jlassahn/gamesquirrel/docs/game_programmer_guide.adoc

= GameSquirrel Game Programmer's Guide
Jeff Lassahn
0.1.0, February 23,2025
:copyright: 2025 Jeff Lassahn
:doctype: book
:toc: left
:toc-title: Table of Contents
:title-page:

[preface]
== Preface

TODO This is a book for programmers who want to write games for the GameSquirrel.

== A Chapter

TODO Chapter 1
