jlassahn/gamesquirrel/(threads)

Thread 3 (2025-05-10):

Joystick pads are the wrong size

jlassahn, 2025-05-10:
The four case mounting through hole pads for the joystick are too small.

Thread 4 (2025-05-10):

USB slot is misaligned

jlassahn, 2025-05-10:
USB connector position was moved to keep the PCB pads clear of one of the display supports.  The slot in the case must be moved to match.

Thread 5 (2025-05-10):

Switch position doesn't match slot.

jlassahn, 2025-05-10:
The power switch location on the PCB isn't aligned with the slot in the case.  Probably an error during PCB layout.
Will fix by adjusting the case design.

Thread 8 (2025-05-10):

Case PCB supports interfere with through-hole components.

jlassahn, 2025-05-10:
The joystick and indicator LEDs both have through-hole pins that make contact with the case PCB support grid.  Add cutouts as needed to make everything fit.

Thread 9 (2025-05-10):

Case top is too flexible

jlassahn, 2025-05-10:
When held with the single mounting screw, the case top is flexible enough to allow the corners near the display to bend noticeably.

Thread 10 (2025-05-11):

Oscillator chip is hard to hand solder

jlassahn, 2025-05-11:
The 16MHz Oscillator chip has pads that aren't easily reachable by a soldering iron, so it's hard to solder.  Consider choosing a different part, or making the pads bigger on the PCB.

Thread 11 (2025-05-11):

Buttons are in the wrong order

jlassahn, 2025-05-11:
The four buttons are laid out on the PCB in a weird order.

The current positions are
```
SW1  SW4
SW3  SW2
```

It was supposed to be
```
SW1  SW2
SW3  SW4
```

If fixing this on the PCB, **Make sure to not break compatibility with existing firmware**, probably the best strategy is to change the reference designators so the PCB looks right but leave the mapping between microcontroller pins and button physical positions the same.

Thread 12 (2025-05-11):

Add power On/Off labels to PCB silkscreen

jlassahn, 2025-05-11:
It would be helpful if there was a label next to SW5 that says which switch position is ON.

Thread 14 (2025-05-14):

Debug connectors interfere with display ribbon cable

jlassahn, 2025-05-14:
If the debug and boot headers are populated, the display can't lay normally above the PCB.

Thread 15 (2025-05-18):

D1 LED pins are reversed

jlassahn, 2025-05-18:
On the PCB, negative is marked as pin 1.

Thread 16 (2025-05-18):

Vbat diode dop is too small

jlassahn, 2025-05-18:
The diode added to keep Vbat going into the microcontroller, from exceeding maximum rated voltage doesn't appear to be doing that.

The current drawn by the micro on Vbat is so small that the voltage drop is much lower than 0.6V, hard to measure exactly because my multimeter is drawing enough current to skew the voltage measurement, but probably we're getting less than 0.2V.

The requirement for the micro is 4.0V absolute max, 3.6V recommended operating max.  The datasheet typical value for the diode drop is 0.6V at about 0.15mA, slope of about 0.2V per 10x current change.

Consider adding a bleed resistor to keep the diode in forward conduction. 100K would draw about 40uA, which would give voltage drop of just under 0.5V.  At maximum battery voltage of 4.2V this gives a Vbat around 3.7-3.8V, which is probably OK.  The battery drain from 40uA is 400mAH in 10,000 hours, which is more than a year.  So the extra power down current use should be fine.
