jlassahn/gamesquirrel/hardware/main_pcb/main_pcb.kicad_pcb

## KiCad design hardware/main_pcb/main_pcb.kicad_pcb (2025-04-23)

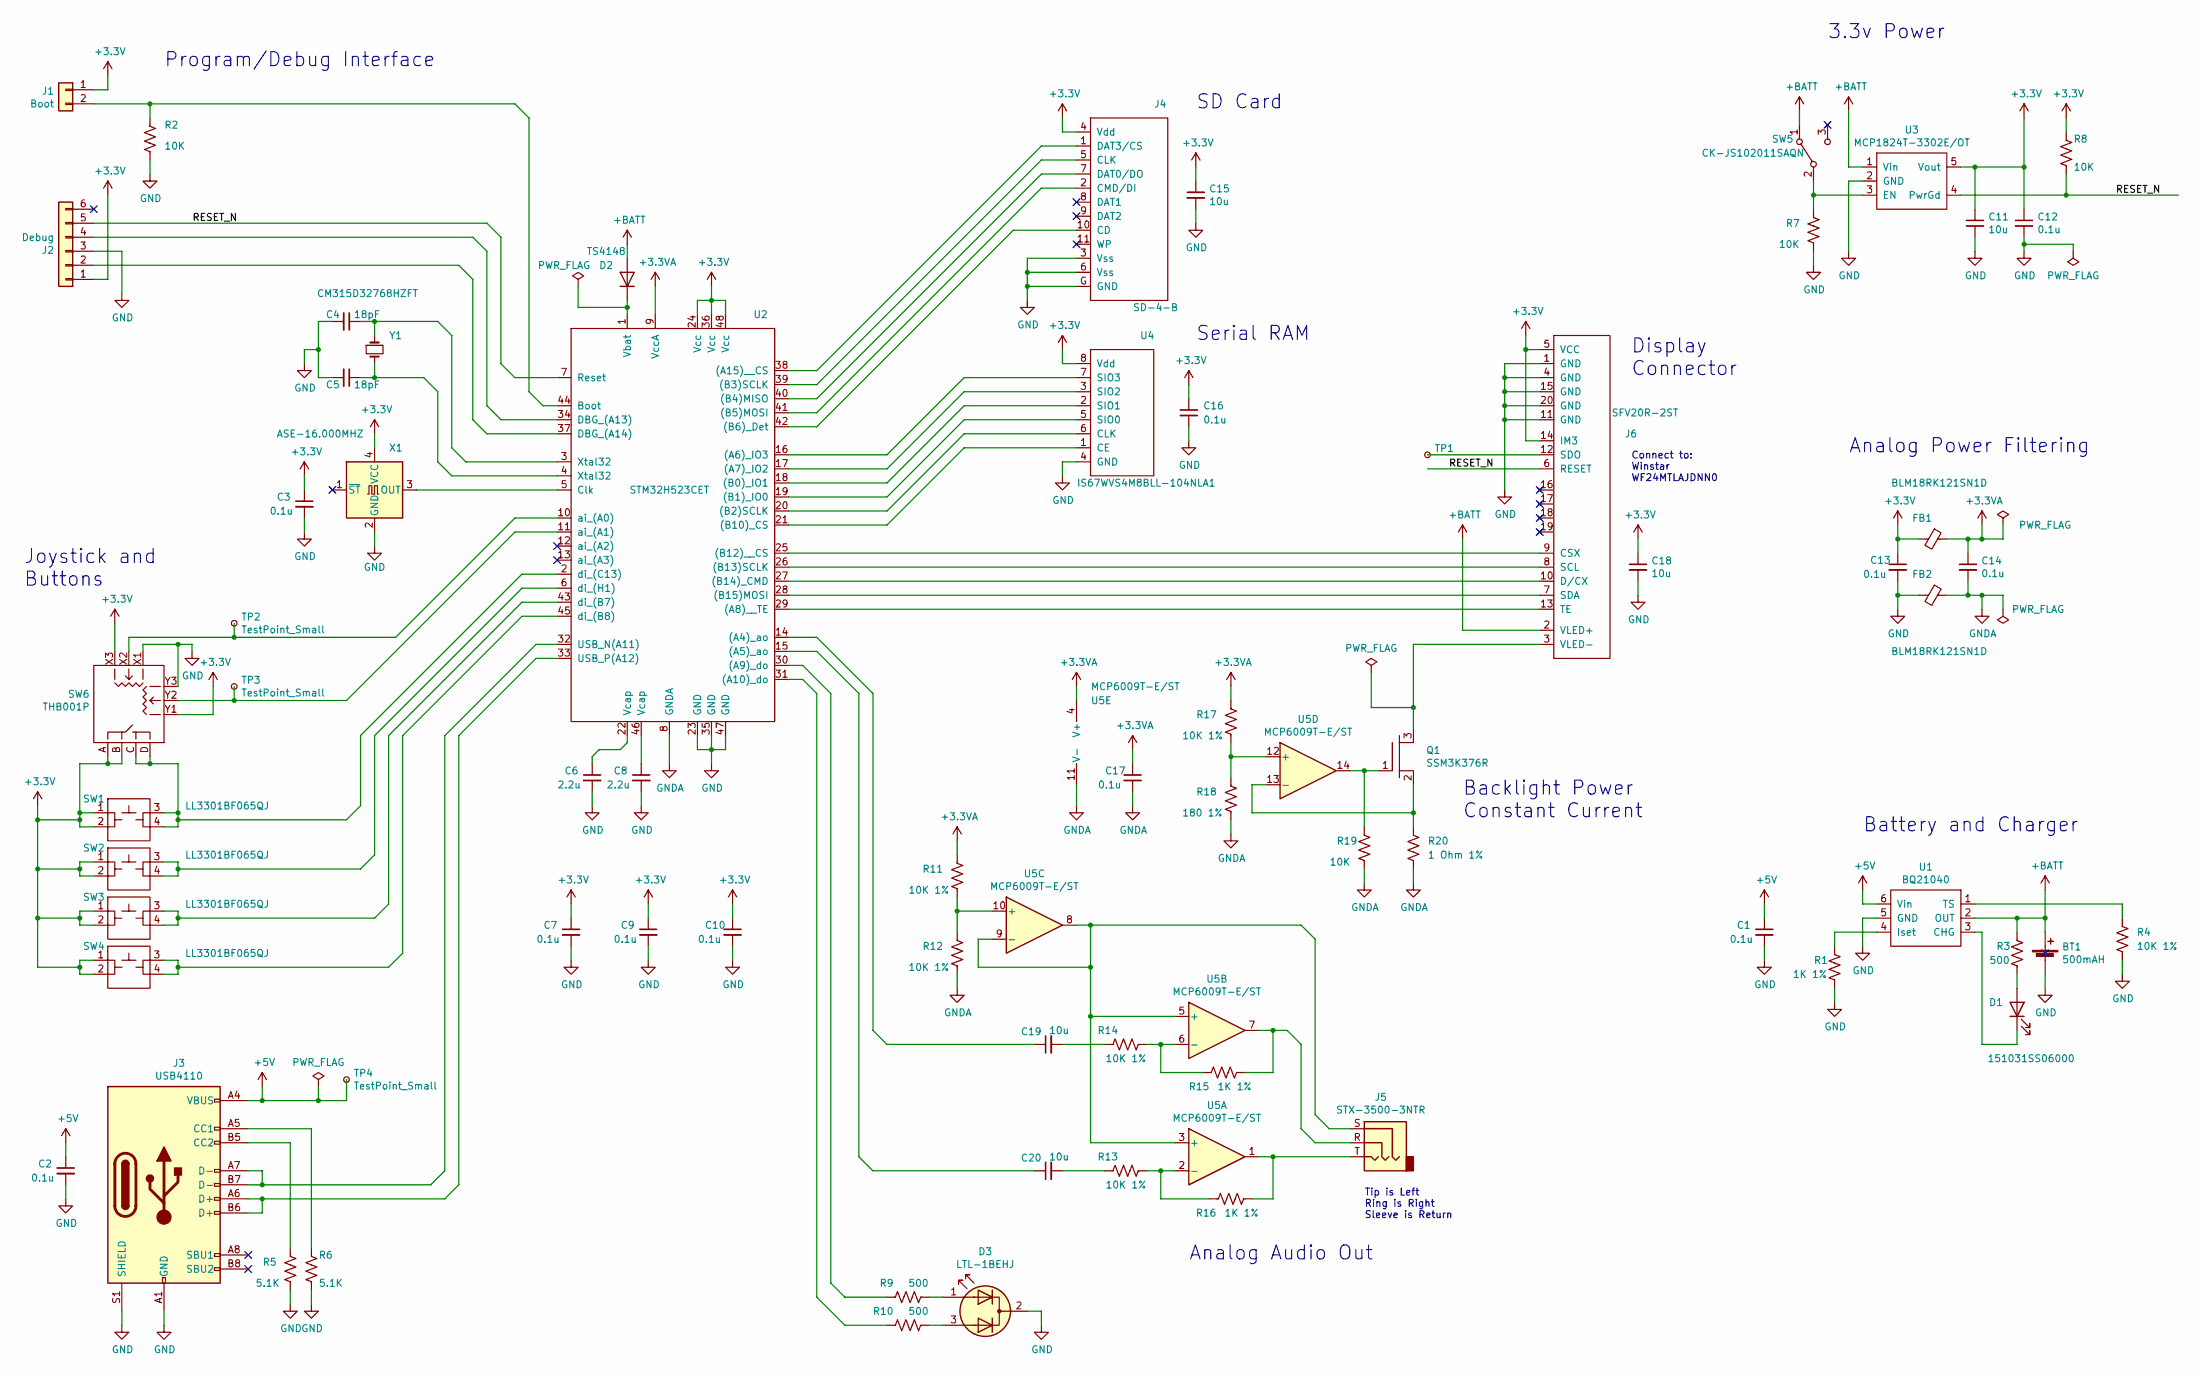
[picture p1: schematic main_pcb.sch, GameSquirrel Main Circuit Board]

Parts:
BT1: 500mAH; PinHeader_1x02_P1.27mm_Vertical
C1, C2, C3, C7, C9, C10, C12, C13, C14, C16, C17: 0.1u; C_0603_1608Metric
C4, C5: 18pF; C_0603_1608Metric
C6, C8: 2.2u; C_0603_1608Metric
C11, C15, C18, C19, C20: 10u; C_0805_2012Metric
D1: 151031SS06000; LED_D3.0mm
D2: TS4148; D_0603_1608Metric
D3: LTL-1BEHJ; LED_D3.0mm-3
FB1, FB2: BLM18RK121SN1D; R_0603_1608Metric
J1: Boot; PinSocket_1x02_P2.54mm_Vertical
J2: Debug; PinSocket_1x06_P2.54mm_Vertical
J3: USB4110
J4: SD-4-B
J5: STX-3500-3NTR; Jack_3.5mm_CUI_SJ-3523-SMT_Horizontal
J6: SFV20R-2ST; FPC_1x20_P0.5mm_top
Q1: SSM3K376R; SOT-23
R1, R15, R16: 1K 1%; R_0603_1608Metric
R2, R7, R8, R19: 10K; R_0603_1608Metric
R3, R9, R10: 500; R_0603_1608Metric
R4, R11, R12, R13, R14, R17: 10K 1%; R_0603_1608Metric
R5, R6: 5.1K; R_0603_1608Metric
R18: 180 1%; R_0603_1608Metric
R20: 1 Ohm 1%; R_0603_1608Metric
SW1, SW2, SW3, SW4: LL3301BF065QJ; LL3301-J
SW5: CK-JS102011SAQN; SW_SPDT_CK-JS102011SAQN
SW6: THB001P
TP1, TP2, TP3, TP4: TestPoint_Small; TestPoint_Pad_D1.5mm
U1: BQ21040; TSOT-23-6
U2: STM32H523CET; LQFP-48_7x7mm_P0.5mm
U3: MCP1824T-3302E/OT; TSOT-23-5
U4: IS67WVS4M8BLL-104NLA1; SOIC-8_3.9x4.9mm_P1.27mm
U5: MCP6009T-E/ST; TSSOP-14_4.4x5mm_P0.65mm
X1: ASE-16.000MHZ; Oscillator_SMD_Abracon_ASE-4Pin_3.2x2.5mm
Y1: CM315D32768HZFT; Crystal_SMD_3215-2Pin_3.2x1.5mm

Connections:
+3.3VA: C14.1, C17.1, FB1.1, R11.1, R17.1, U2.9 (VccA), U5.4 (V+)
+3V3: C3.1, C7.1, C9.1, C10.1, C11.1, C12.1, C13.1, C15.1, C16.1, C18.1, FB1.2, J1.1, J2.1, J4.4 (Vdd), J6.5 (VCC), J6.14 (IM3), R8.1, SW1.1, SW1.2, SW2.1, SW2.2, SW3.1, SW3.2, SW4.1, SW4.2, SW6.A, SW6.B, SW6.X3, SW6.Y1, U2.24 (Vcc), U2.36 (Vcc), U2.48 (Vcc), U3.5 (Vout), U4.8 (Vdd), X1.4 (VCC)
+5V: C1.1, C2.1, J3.A4 (VBUS), J3.A9 (VBUS), J3.B4 (VBUS), J3.B9 (VBUS), TP4.1, U1.6 (Vin)
+BATT: BT1.1 (+), D2.2 (A), J6.2 (VLED+), R3.1, SW5.1 (A), U1.2 (OUT), U3.1 (Vin)
/RESET_N: J2.5, J6.6 (RESET), R8.2, U2.7 (Reset), U3.4 (PwrGd)
GND: BT1.2 (-), C1.2, C2.2, C3.2, C4.2, C5.2, C6.2, C7.2, C8.2, C9.2, C10.2, C11.2, C12.2, C13.2, C15.2, C16.2, C18.2, D3.2 (K), FB2.2, J2.3, J3.A1 (GND), J3.A12 (GND), J3.B1 (GND), J3.B12 (GND), J3.S1 (SHIELD), J4.3 (Vss), J4.6 (Vss), J4.G (GND), J6.1 (GND), J6.4 (GND), J6.11 (GND), J6.15 (GND), J6.20 (GND), R1.2, R2.2, R4.2, R5.2, R6.2, R7.2, SW6.X1, SW6.Y3, U1.5 (GND), U2.23 (GND), U2.35 (GND), U2.47 (GND), U3.2 (GND), U4.4 (GND), X1.2 (GND)
GNDA: C14.2, C17.2, FB2.1, R12.2, R18.2, R19.2, R20.2, U2.8 (GNDA), U5.11 (V-)
unnamed: C4.1, U2.3 (Xtal32), Y1.1
unnamed: C5.1, U2.4 (Xtal32), Y1.2
unnamed: C6.1, U2.22 (Vcap)
unnamed: C8.1, U2.46 (Vcap)
unnamed: C19.1, U2.14 ((A4)_ao)
unnamed: C19.2, R14.1
unnamed: C20.1, U2.15 ((A5)_ao)
unnamed: C20.2, R13.1
unnamed: D1.1 (K), U1.3 (CHG)
unnamed: D1.2 (A), R3.2
unnamed: D2.1 (K), U2.1 (Vbat)
unnamed: D3.1 (A1), R9.2
unnamed: D3.3 (A2), R10.2
unnamed: J1.2, R2.1, U2.44 (Boot)
unnamed: J2.2, U2.37 (DBG_(A14))
unnamed: J2.4, U2.34 (DBG_(A13))
unnamed: J3.A5 (CC1), R6.1
unnamed: J3.A6 (D+), J3.B6 (D+), U2.33 (USB_P(A12))
unnamed: J3.A7 (D-), J3.B7 (D-), U2.32 (USB_N(A11))
unnamed: J3.B5 (CC2), R5.1
unnamed: J4.1 (DAT3/CS), U2.38 ((A15)__CS)
unnamed: J4.2 (CMD/DI), U2.41 ((B5)MOSI)
unnamed: J4.5 (CLK), U2.39 ((B3)SCLK)
unnamed: J4.7 (DAT0/DO), U2.40 ((B4)MISO)
unnamed: J4.10 (CD), U2.42 ((B6)_Det)
unnamed: J5.R, R15.2, U5.7
unnamed: J5.S, U5.3 (+), U5.5 (+), U5.8, U5.9 (-)
unnamed: J5.T, R16.2, U5.1
unnamed: J6.3 (VLED-), Q1.3 (D)
unnamed: J6.7 (SDA), U2.28 ((B15)MOSI)
unnamed: J6.8 (SCL), U2.26 ((B13)SCLK)
unnamed: J6.9 (CSX), U2.25 ((B12)__CS)
unnamed: J6.10 (D/CX), U2.27 ((B14)_CMD)
unnamed: J6.12 (SDO), TP1.1
unnamed: J6.13 (TE), U2.29 ((A8)__TE)
unnamed: Q1.1 (G), R19.1, U5.14
unnamed: Q1.2 (S), R20.1, U5.13 (-)
unnamed: R1.1, U1.4 (Iset)
unnamed: R4.1, U1.1 (TS)
unnamed: R7.1, SW5.2 (B), U3.3 (EN)
unnamed: R9.1, U2.30 ((A9)_do)
unnamed: R10.1, U2.31 ((A10)_do)
unnamed: R11.2, R12.1, U5.10 (+)
unnamed: R13.2, R16.1, U5.2 (-)
unnamed: R14.2, R15.1, U5.6 (-)
unnamed: R17.2, R18.1, U5.12 (+)
unnamed: SW1.3, SW1.4, SW6.C, SW6.D, U2.2 (di_(C13))
unnamed: SW2.3, SW2.4, U2.6 (di_(H1))
unnamed: SW3.3, SW3.4, U2.43 (di_(B7))
unnamed: SW4.3, SW4.4, U2.45 (di_(B8))
unnamed: SW6.X2, TP2.1, U2.10 (ai_(A0))
unnamed: SW6.Y2, TP3.1, U2.11 (ai_(A1))
unnamed: U2.5 (Clk), X1.3 (OUT)
unnamed: U2.16 ((A6)_IO3), U4.7 (SIO3)
unnamed: U2.17 ((A7)_IO2), U4.3 (SIO2)
unnamed: U2.18 ((B0)_IO1), U4.2 (SIO1)
unnamed: U2.19 ((B1)_IO0), U4.5 (SIO0)
unnamed: U2.20 ((B2)SCLK), U4.6 (CLK)
unnamed: U2.21 ((B10)_CS), U4.1 (CE)

Notes on the sheet:
Tip is Left Ring is Right Sleeve is Return
Battery and Charger
Analog Power Filtering
3.3v Power
Analog Audio Out
Backlight Power Constant Current
SD Card
Serial RAM
Display Connector
Joystick and Buttons
Program/Debug Interface
Connect to: Winstar WF24MTLAJDNN0

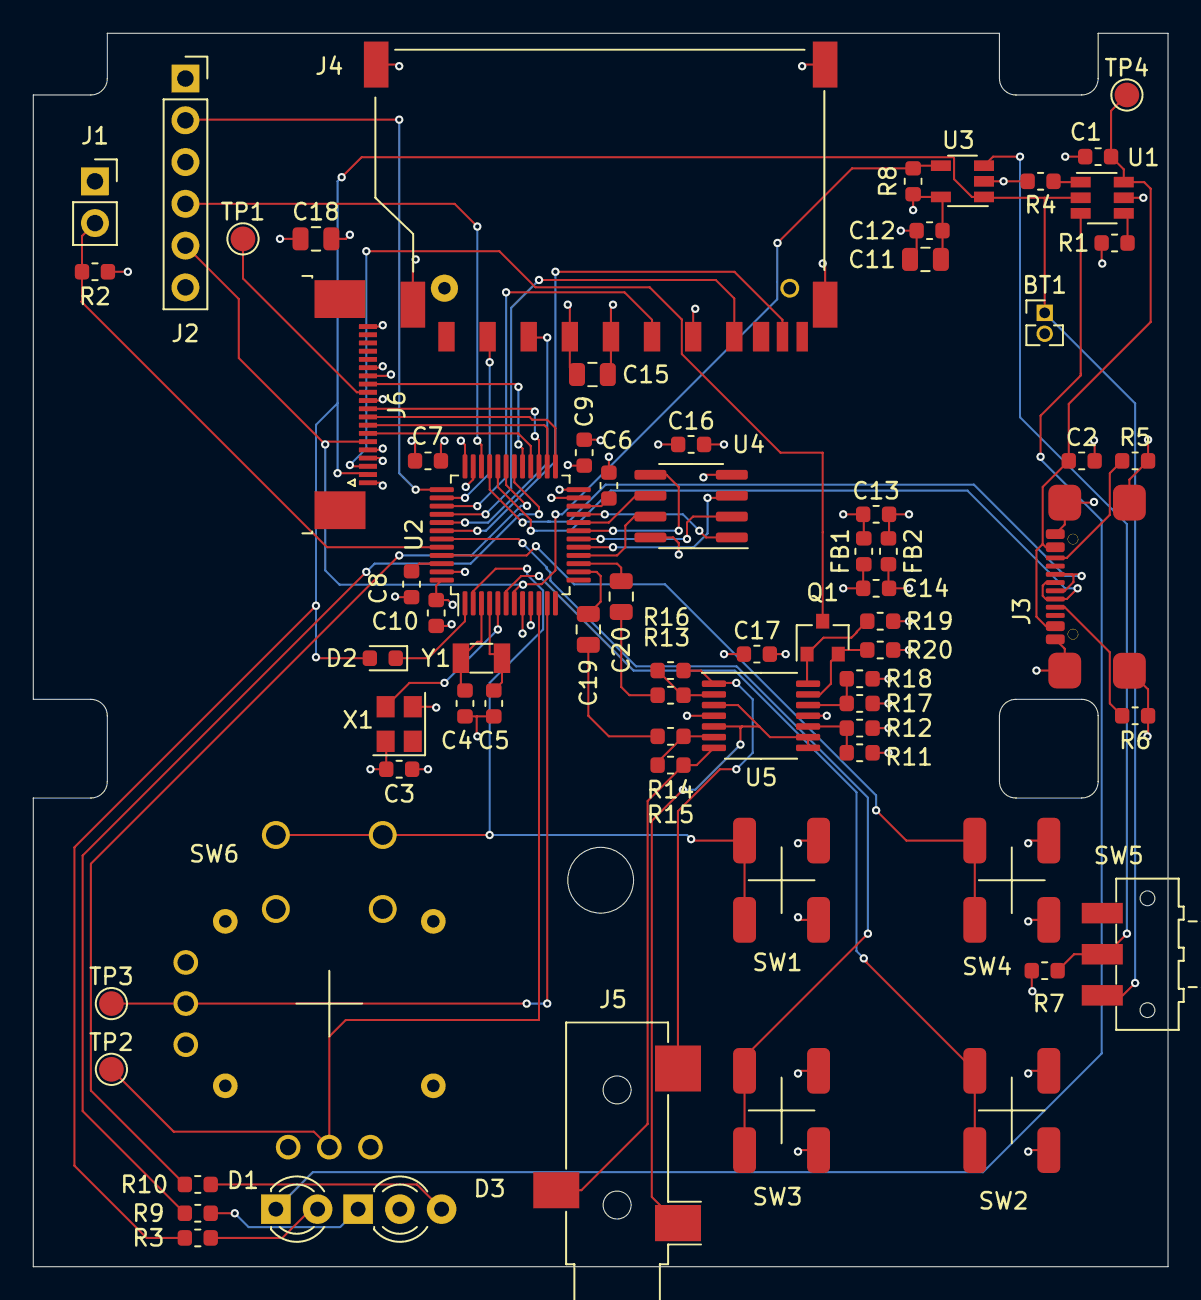
[picture p2: board main_pcb.kicad_pcb from above]

Board: 4 copper layers, 69.0 x 75.0 mm, 70 parts (0 on the bottom side), 66 nets.
