jlassahn/gamesquirrel/software/src/system/main.c

/*
  SPDX-License-Identifier: Apache-2.0
  Copyright 2025 Jeff Lassahn

  Main boot entrypoint into the GameSquirrel system software.
*/

#include <stdint.h>
#include <stdbool.h>

#pragma GCC optimize ("-fno-strict-aliasing")

int main(void)
{
	//hw_init();

	while (true)
	{}

	return 1; // main should never return
}
