jlassahn/gamesquirrel/(commit log)

2025-01-25 Initial KiCAD circuit board design.
    [main_pcb.kicad_pcb, main_pcb.sch]
2025-02-22 License files, initial copy of generated STM32 configurations.
    [main_pcb.kicad_pcb, main_pcb.sch]
2025-03-15 Initial version of geometry OpenSCAD file.
    [geometry.scad]
2025-04-08 File system images for tests. prototype include files.
2025-04-21 Schematic cleanup, replace parts with latest selections, custom footprints for new parts.
    [main_pcb.sch]
2025-04-22 Layout for new PCB geometry.
    [geometry.scad, main_pcb.kicad_pcb]
2025-04-23 Joystick orientation, some trace cleanup, add text to PCB silkscreen.
    [main_pcb.kicad_pcb, main_pcb.sch]
2025-04-27 Minimal gamesquirrel main with UART.
2025-04-30 Prototype USB comm interface.
2025-05-03 USB interrupt handling.
2025-05-11 First version that's working with the real PCB.
2025-05-12 Fix PLL settings, remove unneeded HAL files.
    [main.c]
2025-05-14 More peripheral clock and enable setup. Configure a 1us system timer.
2025-05-18 More timer setup, buttons, variable brightness LEDs.
2025-05-25 Initial prototype of audio out with DMA, beginning of OctoSPI setup.
2025-06-07 Enable SPI interfaces for SD card and Display, enable ADC.
2025-06-14 Reorganize bootstrap and interrupt vector table.
2025-06-15 Add editorconfig file and replace tabs with spaces.
    [audio.c, audio.h, charqueue.h, core.c, display.c, interrupt_vectors.c]
2025-06-17 Make SysTick a free-running timer, add clock delay function.
2025-06-26 Fix analog input zero.
    [core.c, main.c]
