jlassahn/gamesquirrel/(notices)

Notices in the files:
hardware/main_pcb/main_pcb.kicad_pcb:
License: CERN-OHL-P-2.0
